makerprobe/PicoM10/README.md

# PicoM10
A pretty small ublox MIA-M10Q based GNSS module
