makerprobe/PicoM10/kicad/JLCPCB_6L_08_1080A.png

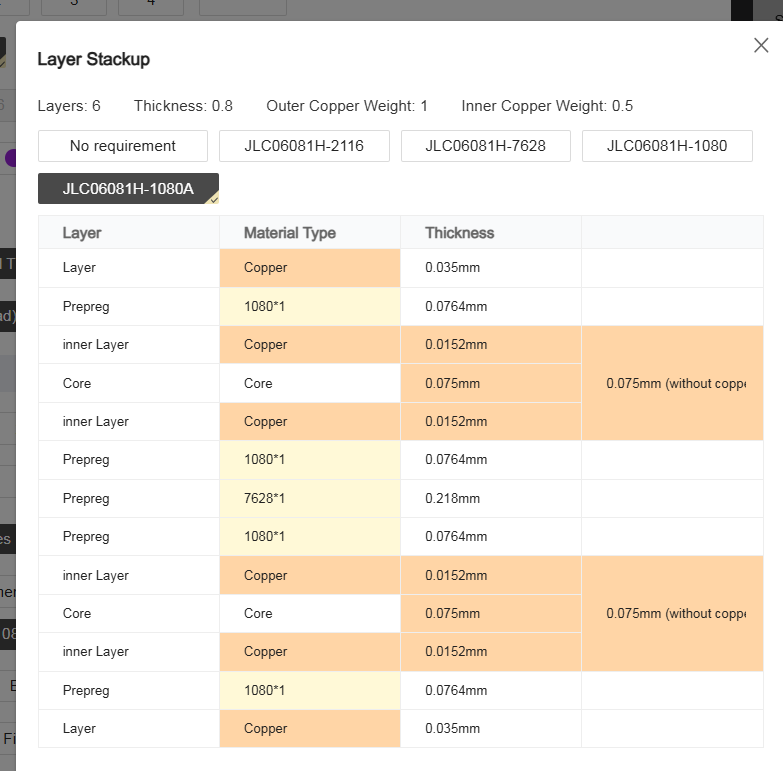
kicad/JLCPCB_6L_08_1080A.png
