makerprobe/PicoM10/kicad/3d_local/ZOE-M8Q--3DModel-STEP-1.STEP

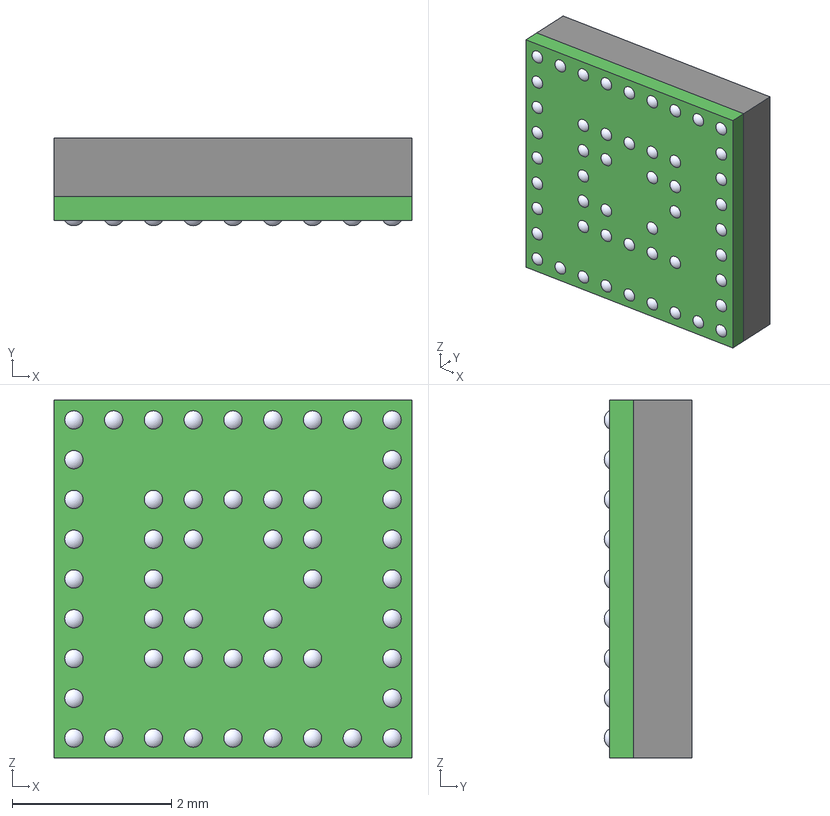
[picture p2: CAD file, 2024-11-04]
kicad/3d_local/ZOE-M8Q--3DModel-STEP-1.STEP
4.50 x 1.10 x 4.50 mm
ZOE-M8Q
ZOE-M8Q018
ZOE-M8Q020
ZOE-M8Q022
ZOE-M8Q005
ZOE-M8Q007
ZOE-M8Q019
ZOE-M8Q002
ZOE-M8Q014
ZOE-M8Q023
ZOE-M8Q015
ZOE-M8Q008
ZOE-M8Q024
ZOE-M8Q012
ZOE-M8Q025
ZOE-M8Q016
ZOE-M8Q004
ZOE-M8Q006
ZOE-M8Q010
ZOE-M8Q013
ZOE-M8Q021
ZOE-M8Q001
ZOE-M8Q009
ZOE-M8Q011
ZOE-M8Q017
ZOE-M8Q003
ZOE-M8Q041
ZOE-M8Q044
ZOE-M8Q038
ZOE-M8Q034
ZOE-M8Q047
ZOE-M8Q049
ZOE-M8Q046
ZOE-M8Q029
ZOE-M8Q035
ZOE-M8Q026
ZOE-M8Q040
ZOE-M8Q042
ZOE-M8Q033
ZOE-M8Q048
ZOE-M8Q050
ZOE-M8Q037
ZOE-M8Q027
ZOE-M8Q028
ZOE-M8Q031
ZOE-M8Q030
ZOE-M8Q032
ZOE-M8Q036
ZOE-M8Q039
ZOE-M8Q043
ZOE-M8Q045
ZOE-M8Q052
ZOE-M8Q051
ZOE-M8Q053
