makerprobe/PicoM10/kicad/PicoM10_bld_20250521.pdf

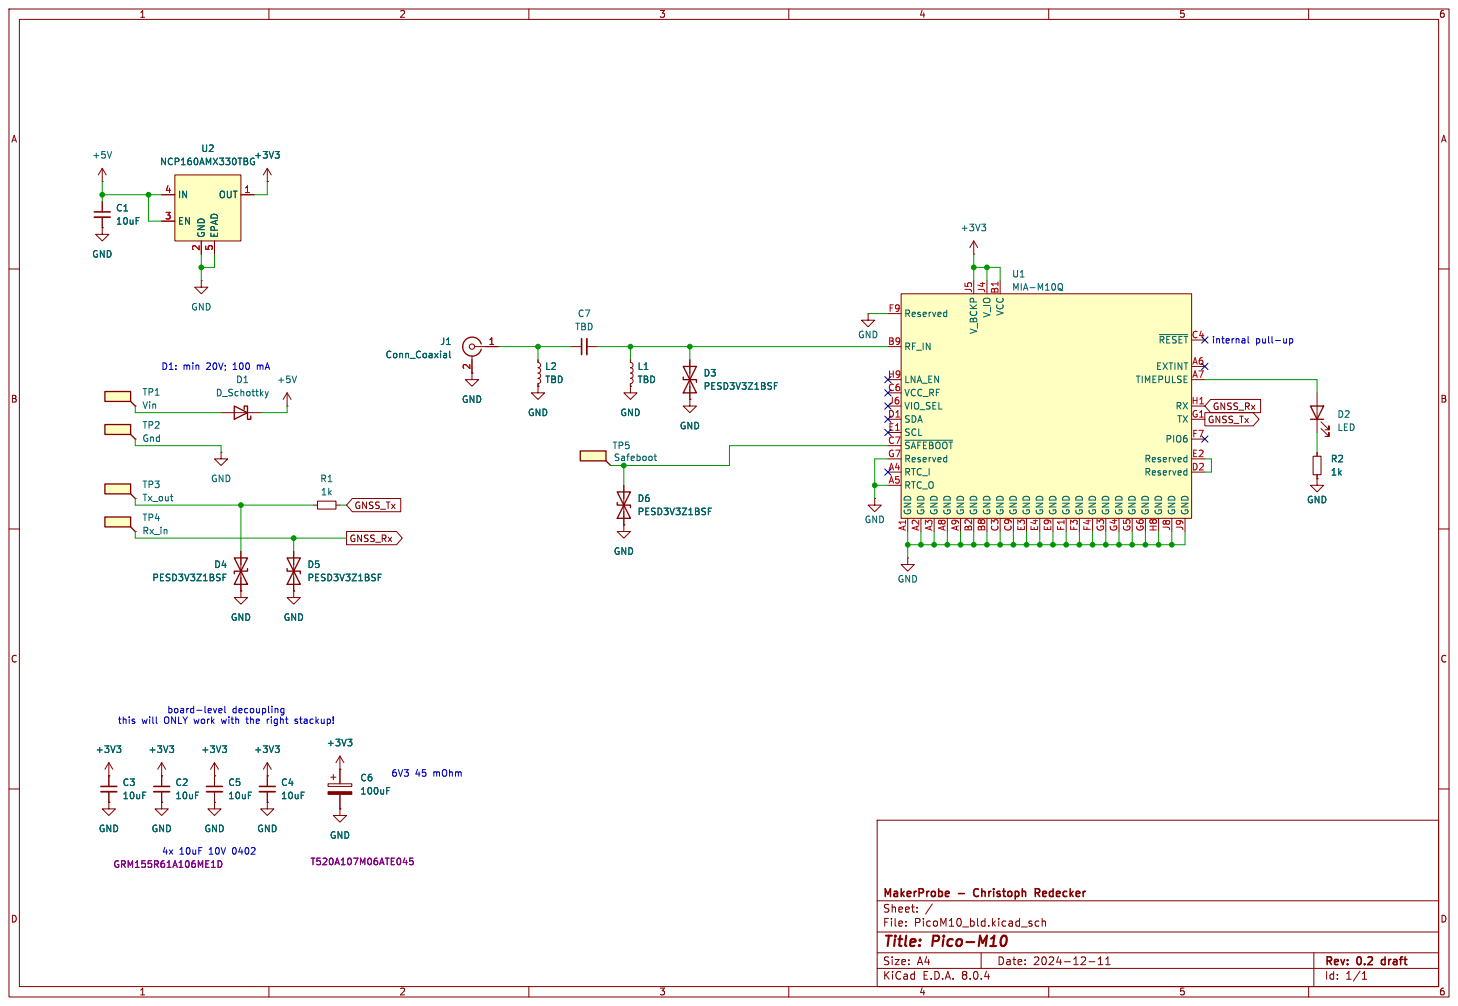
[picture p3: page 1]

this will ONLY work with the right stackup! 4x 10uF 10V 0402
