makerprobe/PicoM10/kicad/PicoM10_bld_20250101_1414.pdf

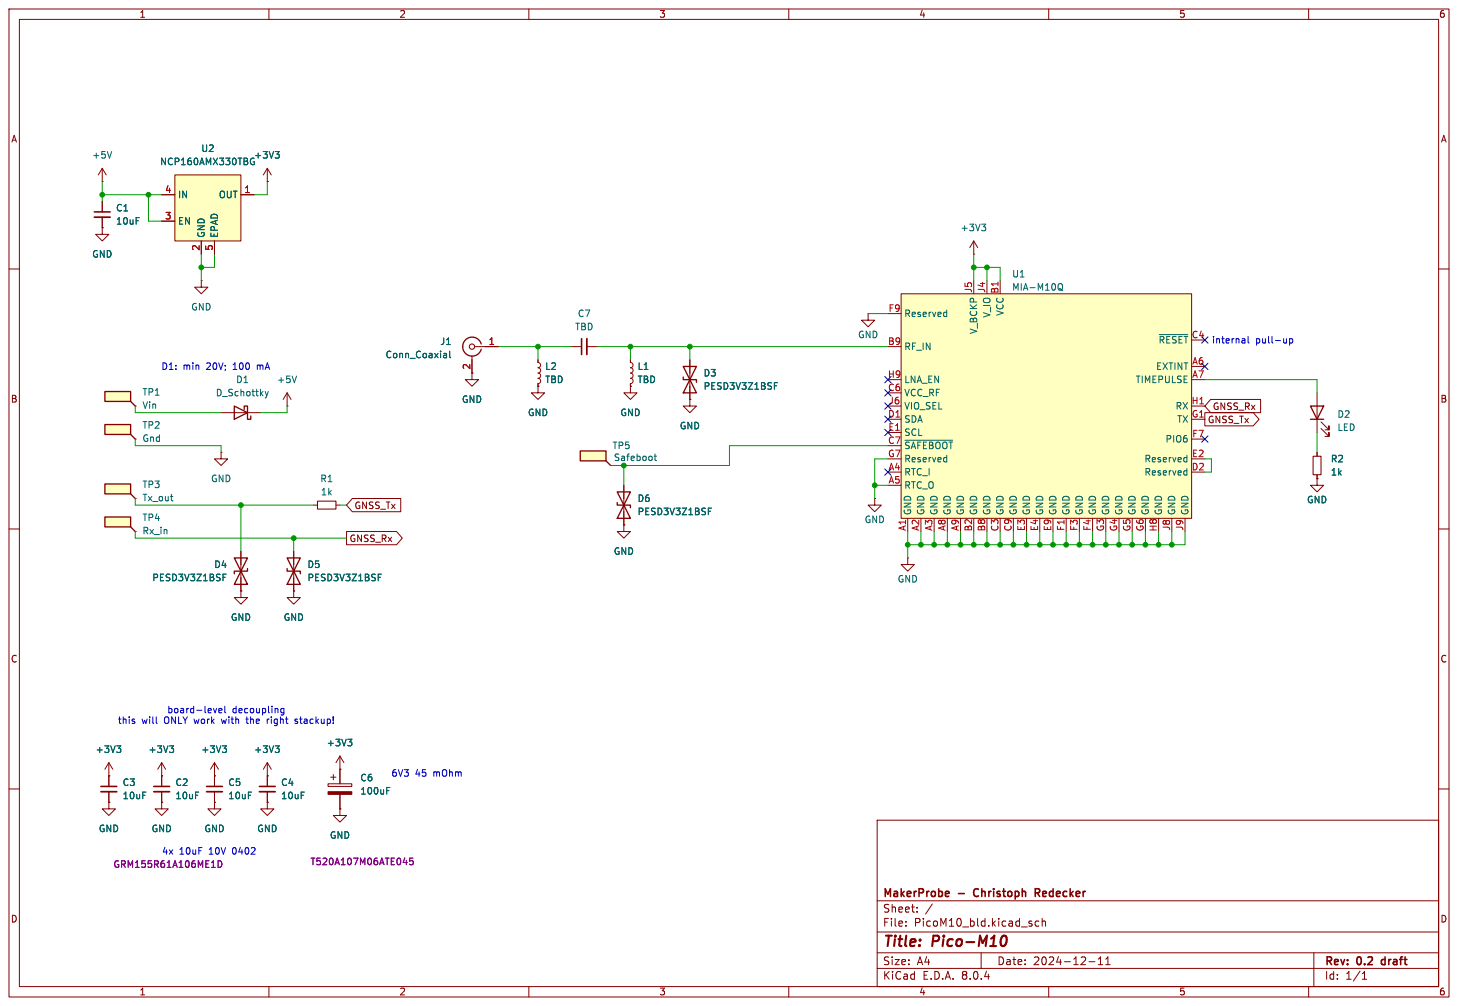
[picture p4: page 1]
