makerprobe/PicoM10/kicad/PicoM10_bld.kicad_pcb

## KiCad design kicad/PicoM10_bld.kicad_pcb (2024-12-11)

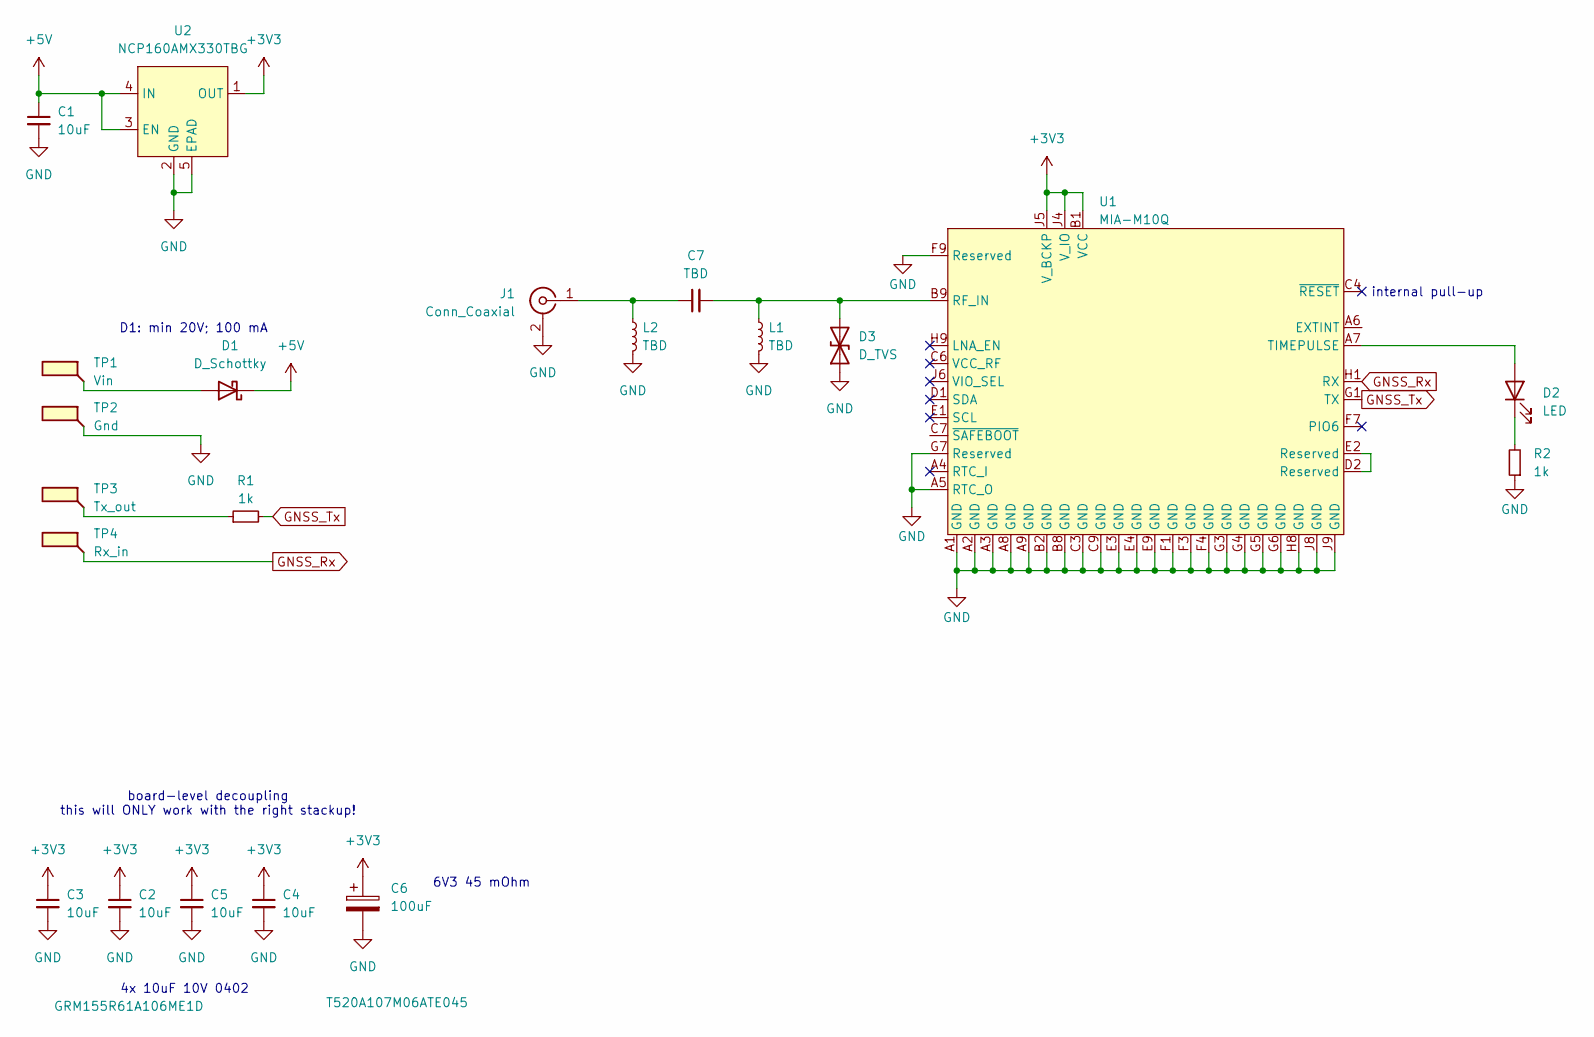
[picture p5: schematic PicoM10_bld.kicad_sch, Pico-M10]

Parts:
C1, C2, C3, C4, C5: 10uF; C_0402_1005Metric; MPN GRM155R61A106ME1D
C6: 100uF; CP_EIA-3216-10_Kemet-I; MPN T520A107M06ATE045
C7: TBD; C_0201_0603Metric_mod
D1: D_Schottky; D_SOD-923
D2: LED; LED_0201_0603Metric_mod
D3: D_TVS; Nexperia_DSN0603-2_0.6x0.3mm_P0.4mm
J1: Conn_Coaxial; U.FL_Molex_MCRF_73412-0110_Vertical; MPN CONMHF1-SMD-G-T
L1, L2: TBD; C_0201_0603Metric_mod
R1, R2: 1k; R_0201_0603Metric_mod
TP1: Vin; solderpad_castellated_2x2mm
TP2: Gnd; solderpad_castellated_2x2mm
TP3: Tx_out; solderpad_castellated_2x2mm
TP4: Rx_in; solderpad_castellated_2x2mm
U1: MIA-M10Q; SLGA-53_MIA-M10Q; MPN MIA-M10Q
U2: NCP160AMX330TBG; UDFN-4-1EP_1x1mm_P0.65mm_EP0.48x0.48mm; MPN NCP160AMX330TBG

Connections:
+3V3: C2.1, C3.1, C4.1, C5.1, C6.1, U1.B1 (VCC), U1.J4 (V_IO), U1.J5 (V_BCKP), U2.1 (OUT)
+5V: C1.1, D1.1 (K), U2.3 (EN), U2.4 (IN)
GND: C1.2, C2.2, C3.2, C4.2, C5.2, C6.2, D3.1 (A1), J1.2 (Ext), L1.2, L2.2, R2.1, TP2.1, U1.A1 (GND), U1.A2 (GND), U1.A3 (GND), U1.A5 (RTC_O), U1.A8 (GND), U1.A9 (GND), U1.B2 (GND), U1.B8 (GND), U1.C3 (GND), U1.C9 (GND), U1.E3 (GND), U1.E4 (GND), U1.E9 (GND), U1.F1 (GND), U1.F3 (GND), U1.F4 (GND), U1.F9 (Reserved), U1.G3 (GND), U1.G4 (GND), U1.G5 (GND), U1.G6 (GND), U1.G7 (Reserved), U1.H8 (GND), U1.J8 (GND), U1.J9 (GND), U2.2 (GND), U2.5 (EPAD)
GNSS_Rx: TP4.1, U1.H1 (RX)
GNSS_Tx: R1.2, U1.G1 (TX)
unnamed: D1.2 (A), TP1.1
unnamed: D2.2 (A), U1.A7 (TIMEPULSE)
unnamed: D2.1 (K), R2.2
unnamed: C7.2, D3.2 (A2), L1.1, U1.B9 (RF_IN)
unnamed: C7.1, J1.1 (In), L2.1
unnamed: R1.1, TP3.1
unnamed: U1.D2 (Reserved), U1.E2 (Reserved)

Notes on the sheet:
D1: min 20V; 100 mA
4x 10uF 10V 0402
board-level decoupling this will ONLY work with the right stackup!
internal pull-up
6V3 45 mOhm

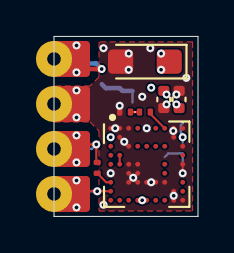
[picture p6: board PicoM10_bld.kicad_pcb from above]

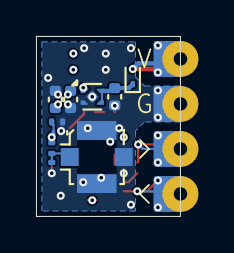
[picture p7: board PicoM10_bld.kicad_pcb from below]

Board: 6 copper layers, 8.0 x 10.0 mm, 21 parts (10 on the bottom side), 12 nets.
