makerprobe/PicoM10/PicoM10_usage.pdf

# Pico-M10

ublox MIA-M10Q based GNSS module 20241104

## Features and data

- ublox MIA-M10Q receiver
- Voltage at supply pin: 4.5 … 5.5 V
- Voltage at Rx pin: 0.0 … 3.3 V
- Antenna connection: 50 Ohm through u.Fl
- Timepulse LED (active high)
- Dimensions: 10.0 mm x 8.0 mm
- Protocols: All protocols supported by the MIA-M10Q via UART

## Connections

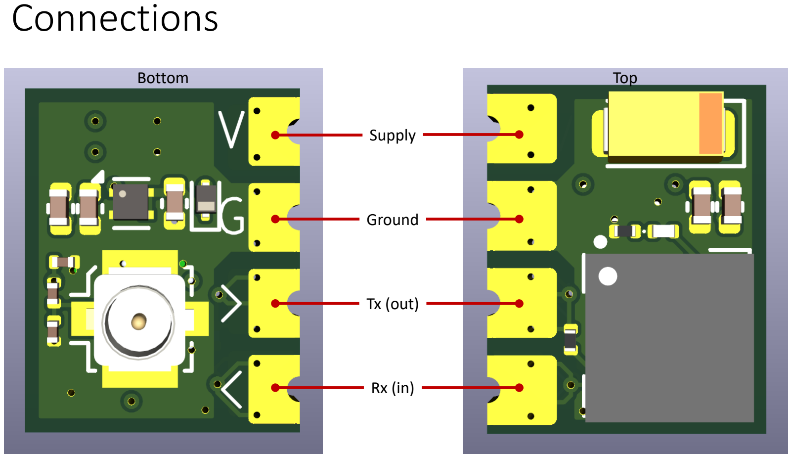
[picture p8: page 3]

Supply

Ground

Tx (out)

Rx (in)

Bottom | Top
