makerprobe/PicoM10/(commit log)

2024-11-04 initial kicad commit
    [PicoM10.kicad_pcb, PicoM10.kicad_sch, PicoM10_bld.kicad_pcb, PicoM10_bld.kicad_sch, ZOE-M8Q--3DModel-STEP-1.STEP]
2024-11-04 move to kicad folder
    [PicoM10.kicad_pcb, PicoM10.kicad_sch, PicoM10_bld.kicad_pcb, PicoM10_bld.kicad_sch, ZOE-M8Q--3DModel-STEP-1.STEP]
2024-11-04 minor cleanup and updates
    [PicoM10.kicad_pcb, PicoM10.kicad_sch, PicoM10_bld.kicad_pcb, PicoM10_bld.kicad_sch]
2024-11-04 minor update
    [PicoM10_bld.kicad_pcb, PicoM10_bld.kicad_sch]
2024-11-05 minor schematic and layout updates
    [PicoM10_bld.kicad_pcb, PicoM10_bld.kicad_sch]
2024-11-05 M10 mask and paste, minor updates
    [PicoM10_bld.kicad_pcb]
2024-12-11 add TVS diode
    [PicoM10_bld.kicad_pcb, PicoM10_bld.kicad_sch]
